rocioparra/E2_TP1/Informe/e2_tp1_main.tex

\documentclass{article}

% preambulo:
\input{e2_tp1_preamble.tex}

\begin{document}

\newgeometry{} % margenes default para la caratula
% caratula:
\input{e2_tp1_caratula.tex}

% indice:
\tableofcontents
\newpage

% cambio los margenes para el resto del documento
\newgeometry{total={6in, 8in}}
\subfile{e2_tp1_intro.tex}
\subfile{e2_tp1_protec.tex}

\begin{figure}[htp]
	\centering
	\fbox{
	\includegraphics
	[width=\textwidth]
	{imagenes/pcb_3d_view.JPG}
	}
	\caption{3D del medelo del PCB dise\~nado}
	\label{fig:placa}
\end{figure}

\subfile{e2_tp1_barkhausen.tex}
\subfile{e2_tp1_disipador.tex}
\subfile{e2_tp1_carac_salida.tex}
\subfile{e2_tp1_ej1.tex}
\subfile{e2_tp1_ej2.tex}

\section{Conclusiones}

La fuente regulada de tensi\'on dise\~nada es capaz de regular correctamente entre 9V y 15V de salida, con hasta 1.5A de corriente.

La protecci\'on foldback del circuito logr\'o reducir a 1A la corriente con tensi\'on de salida 0. Siendo que incluso as\'i se podr\'ian disipar m\'as de 20W en el transistor de paso, y su temperatura aumentaba considerablemente incluso con un disipador de 3.5$\nicefrac{W}{^\circ C}$,  es razonable suponer que sin este tipo de protecci\'on no se habr\'ia podido evitar que se queme la placa en estas condiciones. Si bien eventualmente se llegar\'ia a un l\'imite por la m\'axima corriente que puede entregar la fuente de corriente al transistor de paso, como al dise\~nar se debe tener en cuenta los $\beta$ m\'inimos de los transistores, y estos tienen una gran dispersi\'on, tambi\'en es dif\'icil conseguir que la corriente m\'axima sea mayor que la que se desea como para garantizar que se pueda utilizar la carga m\'axima, pero no tanto mayor como para que se queme la placa. 

\clearpage

\end{document}
