rocioparra/E2_TP1/Informe/e2_tp1_caratula.tex

\begin{titlepage}
\newcommand{\HRule}{\rule{\linewidth}{0.5mm}}
\center
\mbox{\textsc{\LARGE \bfseries {Instituto Tecnol\'ogico de Buenos Aires}}}\\[1.5cm]
\textsc{\Large 22.12 Electr\'onica II}\\[0.5cm]

\HRule \\[0.6cm]
{ \Huge \bfseries Trabajo de laboratorio 1
\\ Fuente regulada de tensi\'on}\\[0.4cm] % Title of your document
\HRule \\[1.5cm]

{\large

\emph{Grupo 4}\\
\vspace{3px}

\begin{tabular}{lr} 	
\textsc{Bual\'o}, Santiago Andr\'es  & 57557 \\
\textsc{Laguinge}, Juan Mart\'in  & 57430 \\
\textsc{Martorell}, Ariel Antonio  & 56209 \\
\textsc{Parra}, Roc\'io  & 57669 \\
\end{tabular}

\vspace{20px}

\emph{Profesores}\\
\vspace{3px}
\textsc{Hirchoren}, Gustavo Abraham\\ 	
\textsc{Petrucci}, Javier David\\ 	

\vspace{100px}

\begin{tabular}{ll}

Presentado: & 23/04/2019\\

\end{tabular}

}

\vfill

\end{titlepage}
