rocioparra/E2_TP1/PCB/E2_TP1/Project Outputs for E2_TP1/Board Information - pcb_e2_tp1.txt

Board Information Report
Filename     : C:\Users\Jones\Documents\GitHub\E2_TP1\PCB\E2_TP1\pcb_e2_tp1.PcbDoc
Date         : 4/18/2019
Time         : 5:58:12 PM
Time Elapsed : 00:00:00

Routing Information
    Routing completion, 100.00%
    Connections, 43
    Connections routed, 43
    Connections remaining, 0
count : 4
