rocioparra/E2_TP1/Informe/e2_tp1_main.pdf

# Instituto Tecnológico de Buenos Aires

22.12 Electronica II ´

# Trabajo de laboratorio 1 Fuente regulada de tensión

Grupo 4
Bualó, Santiago Andrés | 57557
Laguinge, Juan Martín | 57430
Martorell, Ariel Antonio 56209
Parra, Rocío | 57669

Profesores
Hirchoren, Gustavo Abraham Petrucci, Javier David

Presentado: 23/04/2019

## Índice

1. Introducción | 2
2. Diseño de la fuente regulada de tensión | 3
3. Análisis de la protección | 6
4. Compensación de ganancia | 8
5. Cálculo del disipador | 9
6. Característica de salida | 10
7. Power supply rejection ratio (PSRR) | 12
8. Rendimiento | 13
9. Impedancia de salida | 14
10.Conclusiones | 17

1

## 1. Introducción

En el presente informe, se diseñará una fuente regulada de tensión, realizando un análisis teórico de su funcionamiento, simulando el mismo en LtSpice y finalmente verificando que esto se cumpla con mediciones en el circuito real.
Los requerimientos para el diseño son:
VO [V] | IO MAX [A]
9 < VO < 15 | 1.5

Tabla 1: Requerimientos de la fuente regulada de tensión a diseñar.

Como la tensión de salida no necesita llegar a 0V en regulación, se decidió utilizar la configuración no inversora vista en clase (donde la tensión de salida siempre es mayor a la de referencia).

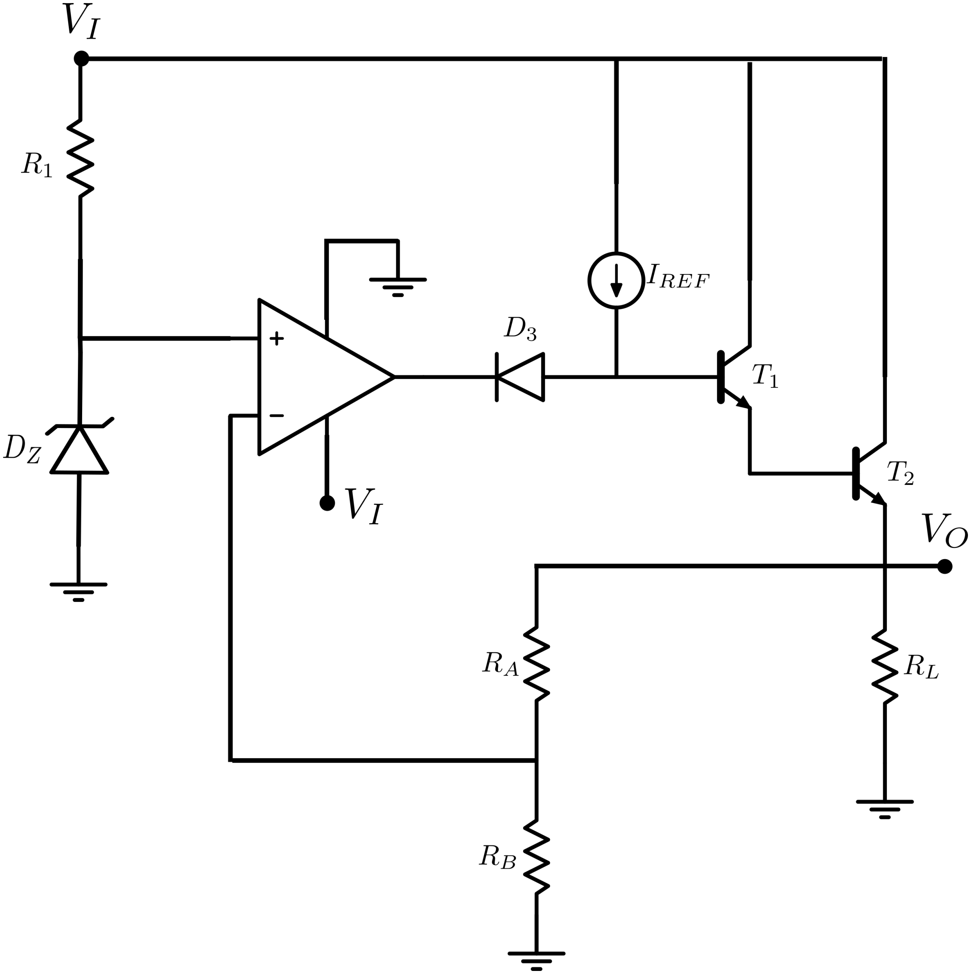
[picture p3: figure]

Figura 1: Diseño básico de la fuente regulada de tensión

2

## 2. Diseño de la fuente regulada de tensión

El circuito básico del que se partió (como se observa en la figura 1) obtiene la tensión de referencia a partir de un diodo Zener, que es comparada mediante un opamp con un divisor resistivo de la tensión de salida. Despreciando la corriente que entra al operacional, la salida se obtiene como:

VO =

1 +

RA
RB
- VZ | (1)

De esta manera, cambiando el valor de RA se puede variar la tensión de salida.
La realimentación se completa con el par Darlington y la fuente de corriente. El par funciona como transistor de paso, aportando la diferencia de tensión necesaria para que VO sea la de regulación. La realimentación del circuito hace que el opamp consuma la corriente suficiente como para que a la base de T1 llegue la justa y necesaria para que la salida se mantenga en regulación. El diodo D1 impide que el opamp entregue corriente, con lo cual la corriente máxima de salida se tiene cuando la totalidad de la entregada por la fuente va al transistor.

### 2.1. Generador y detector

Para obtener el rango establecido en la tabla 1, se decidió utilizar un diodo Zener con tensión nominal de 8.2V, de forma tal que con RB = 47kΩ y utilizando un preset de 50kΩ como RA, se puede llegar a los valores de VO requeridos. Si bien el valor exacto de los componentes no es particularmente relevante en el circuito, se eligieron en este orden de magnitud con el objetivo de que circule por ellos una corriente relativamente pequeña (de alrededor de VZ/RB ' 0.17mA), sin introducir el ruido que una resistencia del orden de los megaohms provocaría.
En cuanto a R1, la presencia de la misma tiene el único propósito de llevar al Zener a regulación. De acuerdo a la hoja de datos de este componente¹
, para que esto ocurra, la corriente debe ser mayor a IZK = 0.5mA, con valor nominal de IZT = 20mA, con su límite superior dado por la potencia de 0.5W que se puede disipar (si bien se trabajó órdenes de magnitud por debajo de este límite, para que el diodo no caliente). En nuestro circuito, esta corriente está dada por:

IZ =

VI − VZ
R1

Por lo tanto, sus mínimos y máximos coincidirán con los de la tensión de entrada. Se consideró que la tensión mínima de entrada es VI M IN = VO M IN + 1.5V = 10.5V, y la máxima, VI MAX = VO MAX + 5V = 20V (sobredimensionando en ambos casos). Se eligió entonces R1 = 560Ω, con lo cual se obtiene IZ M IN = 4.1mA e IZ MAX = 21.1mA.

### 2.2. Circuito de control: par Darlington

Se decidió utilizar dos transistores para el Darlington, en lugar de un integrado, para tener más control sobre el diseño del mismo. Por ejemplo, la mayoría de los pares Darlington del pañol de la universidad poseen resistencias entre la base y el emisor de T2, y lo mismo para T1. Sin embargo, con los transistores elegidos (como se verá a continuación), estas resistencias no ayudan a llevar los β a un punto mejor, y por lo tanto se decidió obviarlas.
A la hora de elegir T1 y T2, la principal consideración que se tuvo es que pudieran soportar holgadamente la corriente máxima. En segundo lugar, se tuvo en cuenta los rangos de β aportados

1https://www.onsemi.com/pub/Collateral/1N5221B-D.PDF, consultada 18/04/19.

3

por el fabricante, buscando el mayor mínimo y la menor dispersión posible. Por último, se consideró también el precio de cada componente listado en el pañol de la universidad.

### 2.2.1. Elección de T2

Para T2, sabemos que debe soportar toda la corriente de salida. Como debemos asegurar que se llegue por lo menos a 1.5A, y este valor dependerá considerablemente de los β, se descargaron modelos que sólo garantizacen correcto funcionamiento hasta 2A o menos. Dejando de lado también los que están diseñados para más de 15A (los cuales suben mucho de precio y pierden demasiado β, y sabemos que no trabajaremos con corrientes tan elevadas), quedaron los modelos listados en la tabla 2.

Modelo | IC MAX (A) | βM IN (veces) | βMAX (veces) | Precio (USD)
TIP31C | 3 | 10 | 50 | 0.26
TIP41A | 6 | 15 | 75 | 0.28
TIP3055 | 15 | 20 | 70 | 0.43

Tabla 2: Características de los modelos considerados para T2

Se observa en dicha tabla el TIP41A posee un β un 50 % mayor y el doble de corriente, por sólo dos centavos de dólar más. Si bien en este circuito 3A son suficientes, puesto que el TIP41A está diseñado para trabajar con corrientes muy superiores a las que necesitamos, mantiene para IO = 2A su valor de β casi sin caída, lo cual no ocurre con el TIP31C. En cuanto al TIP3055, la corriente que soporta es innecesariamente alta, y el β es de similares características al del TIP41A. Como su precio es considerablemente superior al de los otros transistores sin mejoras considerables respecto del TIP41A, se descartó. Se utilizó pues el 41A. Por lo discutido en cuanto a las características de su β en las corrientes que utilizaremos, se decidió no agregar resistencias al par Darlington.

### 2.2.2. Elección de T1

Si sobredimensionamos la corriente máxima de salida un 10 % (puesto que debemos asegurar que se llegue a 1.5A, y por lo tanto diseñar para llegar a más), el otro transistor debe soportar una corriente máxima de:

IT1 MAX =

IT2 MAX

βT2 M IN

≤

1.65A
15

= 110mA

Nótese que incluso considerando 2A se obtienen valores inferiores a 200mA, y sólo con 1.5A se obtiene 100mA, con lo cual podemos decir con confianza que IT1 MAX debe ser superior a 100mA. Descartando los que soportan más de 1A, quedan sólo el 2N3904 y el BC337. Si bien este último cuesta un poco más del doble (0.10U$D contra 0.04U$D), se eligió este modelo de todas maneras por los siguientes motivos:

Ambos tienen el mismo β mínimo, pero el máximo del BC337 es el doble de grande.

Con IC = 100mA, el β del 2N3904 se reduce un 70 %, mientras que la curva del BC337 se encuentra en su máximo en este punto.

El BC está diseñado específicamente para amplificación, y el 2N es de uso general.

4

### 2.3. Amplificador de error

En esta fuente regulada, el amplificador de error consiste en un opamp, que compara (resta) la tensión de referencia, generada por el Zener, con una fracción de la de salida. A la salida del operacional se tendrá la tensión necesaria para minimizar el error.
Este operacional debe contar con la posibilidad de ser alimentado con 0−VCC , en lugar de ±VCC , puesto que se lo alimentará con la tensión de entrada. Debido a limitaciones en la disponibilidad de componentes en el pañol, la única opción disponible que cumplía con nuestros requisitos fue el LM358. Sin embargo, esto no implica que no sea adecuado para la aplicación que le daremos: con 100dB de PSRR, y 100dB también de ganancia, se adapta perfectamente al uso que le daremos, en el cual la alimentación no será necesariamente estable (pues es la entrada) y se requiere la mayor ganancia posible. A su vez, el fabricante asegura que este integrado puede sinkear más de 10mA, con lo cual será capaz de aceptar toda la corriente de referencia sin quemarse.

### 2.4. Pre-regulador: fuente de corriente

La fuente de corriente que se utilizó se observa en la figura 2. El funcionamiento de la misma es el siguiente: la resistencia R5 permite que se polaricen los diodos en directa, generando en la base de T3 una tensión de VB3 = VI − 2VD ' Vin − 1.4V. Luego, cuando el transistor esté correctamente polarizado (lo cual dependerá de la diferencia entre VI y VO), en la resistencia R6 caerá una tensión de VR6 = VI −VE3 = VI −(VB3 +VBE3

) = VI −(VI −2VD +VBE3

) = VD si consideramos VBE3 = VD.

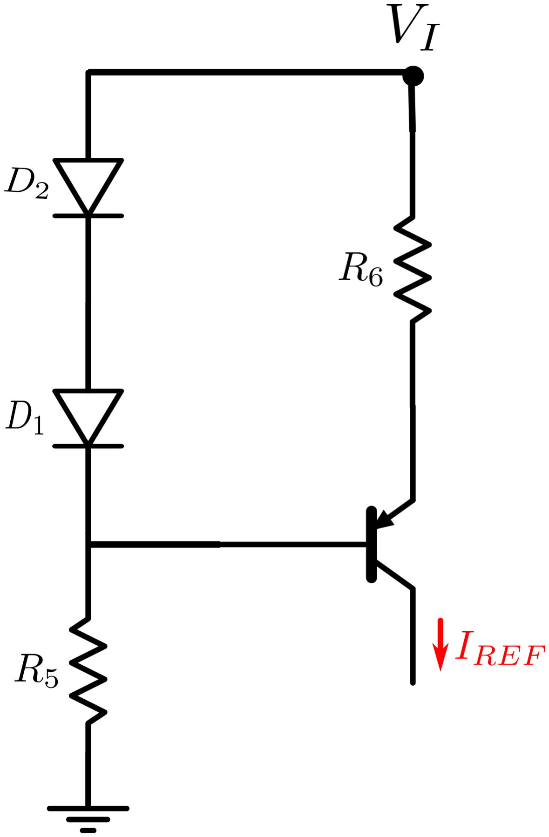
[picture p4: figure]

Figura 2: Fuente de corriente utilizada en el regulador de tensión

Por lo tanto, como la corriente de salida es aproximadamente igual a la de R6 (despreciando IB3

),
se obtiene:

IREF =

0.7V
R6

(2)

Si sobredimensionamos la corriente máxima un 10 % (considerando las aproximaciones que se

5

hicieron, posibles diferencias en las VD y VBE con los 0.7V teóricos, etc), se obtiene:

IREF =

1.1 · IO MAX

βM IN 1 · βM IN 2

=

1.1 · 1.5A
100 · 15

= 1.1mA

Por lo tanto, se eligieron los componentes:

R5 = 10kΩ, con lo cual los diodos se polarizan con una corriente de entre 0.96mA y 1.86mA (dado que la hoja del 1N4148 recomienda 1mA si se quiere 0.7V).

R6 = 642Ω (560 Ω en serie con 82Ω), con lo cual se tiene IO MAX ' 1.6355A, que es lo más cercano que se pudo llegar, con valores comerciales, a los 1.65A que se propuso.

T3 = BC557, un transistor PNP de uso general, que era el más barato (la mitad que el siguiente más barato) y con mayor disponibilidad del pañol de la universidad, y con IC = 100mA y VCE = 45V es más que suficiente para este uso.

## 3. Análisis de la protección

Se decidió utilizar una protección foldback dado que esta evita el pasarnos de la corriente de salida máxima establecida, Iomax´ = 1.5 A y nos limita la cantidad de potencia a disipar por una menor a la dada por una protección lineal reduciendo costos. Al agregar la protección foldback nos quedamos con el siguiente circuito:

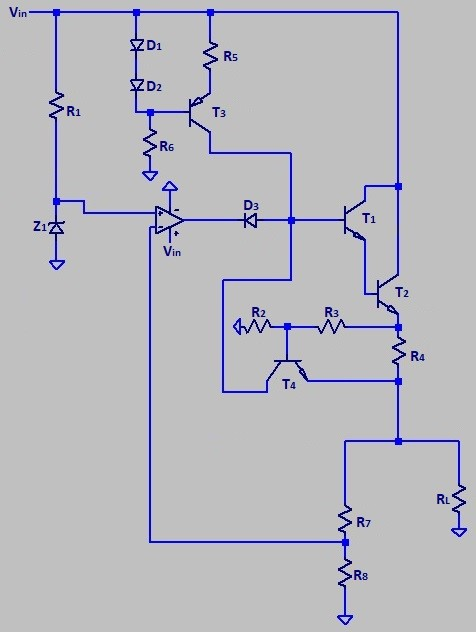
[picture p5: figure]

Figura 3: Circuito con protección

De la figura 3 podemos observar que la protección va a tener los siguientes parámetros:

6

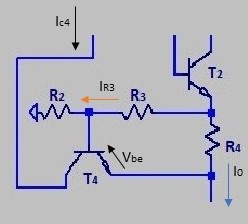
[picture p6: figure]

Figura 4: Análisis del circuito

De la figura 4 al recorrer la malla marcada obtenemos la siguiente ecuación:

(Io − Ie4)R4 = Vbe +

V0 + (Io − Ie4)R4
R2 + R3

R3

Dado que la corriente Ie4 es la corriente que viene de la fuente de corriente y debido a que la corriente Io es dado por β1β2 podemos despreciar la corriente Ie4 dando como resultado la siguiente ecuación:

IoR4 = Vbe +

V0 + IoR4
R2 + R3

R3

Para la elección de los componentes se fijaron los componentes R3 y R4 de forma tal que el componente R2 se elige a partir del siguiente despeje:

R2 =

(Vo + IOR4)R3

I0R4 − Vbe

R3 − R3

Se despejo el valor de R2 utilizando las siguientes condiciones:

Elemento | Valor
R4 | 0.6 Ω
R3 | 1 kΩ
Vo | 9 V
I0 | 1, 58 A

Dando como resultado que R2 = 396112 Ω donde asumiendo la posibilidad de un error del 8 % se eligió a I0 como el valor dado por 3 así como el valor de Vo fue elegido para mantener la máxima corriente requerida incluso para el valor más chico de Vo. Finalmente, con la simulación generada en LTSpice se vario ligeramente el valor para tener el resultado querido, dando como valor final a R2 = 39 kΩ. Al realizar la comprobación empírica para obtener lo querido se tuvo que cambiar R3 = 1, 5 kΩ dando como resultado final los siguientes valores para los componentes:

Elemento | Valor
R4 | 0.6 Ω
R3 | 1, 5 kΩ
R2 | 39 kΩ

7

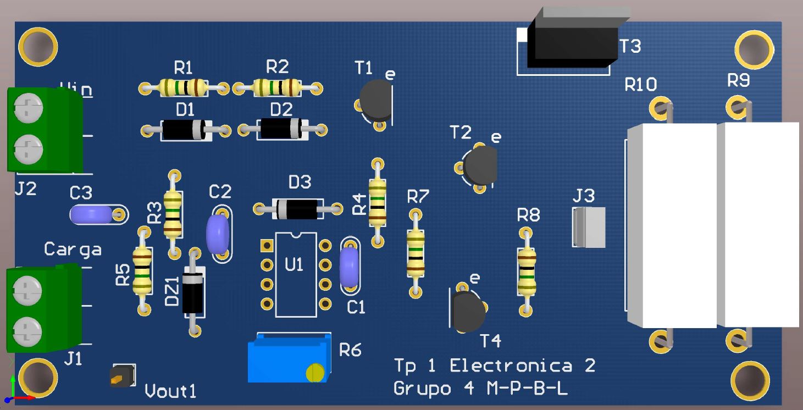
[picture p7: figure]

Figura 5: 3D del medelo del PCB diseñado

## 4. Compensación de ganancia

Si bien el comportamiento del circuito que más nos interesa es en continua, las múltiples capacida-des de juntura y el lazo de realimentación provocan que la respuesta en frecuencia de este circuito no sea constante. Por lo tanto, surge la necesidad de garantizar que para ninguna frecuencia se cumpla el criterio de Barkhausen, es decir:
(
|T(f)| = 1
T(f) = 180◦

Una forma de garantizar que esto no ocurra es forzar la existencia de un polo en bajas frecuencias, de forma tal que se llegue a 0dB para frecuencias bajas y controlando que ese salto no sea en simultáneo con una fase cercana a 180◦ para que el sistema no oscile
Se procuró lograr esto insertando un capacitor entre la salida del amplificador de error y la realimentación, de forma tal que en altas frecuencias (cuando el capacitor es un cable) la señal se vea atenuada. Al simular con un capacitor de 10nF, se obtuvieron los márgenes observados en la tabla 3.
Margen de amplitud (dB) | 12.9
Margen de fase (◦ ) | 90

Tabla 3: Márgenes de ganancia y amplitud con C=10nF

8

## 5. Cálculo del disipador

### 5.1. Introducción

Cuando uno o varios componentes electrónicos de un circuito por cuestiones de diseño deben disipar mucha potencia (traducida en calor al exterior), generalmente dichos dispositivos no son capaces de hacerlo sin llegar a la propia falla y/o romperse. Es por esto que para estos casos se utilizan los llamados disipadores térmicos. Estos disipadores son piezas generalmente metálicas que utilizando las leyes de la termodinámicas son capaces de extraerle calor al componente y liberarlo al ambiente. Existen disipadores de varias formas, tamaños y materiales.

### 5.1.1. Fundamento matemático

Gracias a la física, es posible establecer una analogía entre la ley de Ohm para corrientes y la propagación térmica del calor en los distintos materiales, de manera tal como podemos observar en la tabla siguiente:

Ley de Ohm | Propagación térmica
Intensidad de corriente (I) | Calor (W)
Tensión (V) | Temperatura (T)
Resistencia (R) | Resistencia Termica (R)
V = I · R | T = W · R

Tabla 4: Analogía térmica-ley de Ohm.

Siendo el calor expresado en Watts, la temperatura expresada en oC, y la resistencia térmica expresada en oC/W.
La resistencia térmica, al igual que la resistencia para la ley de Ohm, es inherente a cada material en sí, de manera tal de que por ejemplo un aislante térmico posee alta resistencia térmica, y un conductor térmico perfecto posee baja resistencia térmica.

### 5.2. Elección del disipador

### 5.2.1. Cálculo de Potencia máxima disipada

Correspondiente al análisis que se hizo del circuito en puntos anteriores, el transistor de nuestro circuito que mayor potencia va a disipar es el transistor T2, correspondiente al par dárlington, el cual por diseño va a tener que soportar una corriente cercana de aproximadamente 1.5 A. Para hallar la potencia máxima que este transistor disipa, primero debemos saber en qué condiciones va a hacerlo. Para ello, sabiendo que:
(
PDT 2 = [Vi − V0(i0)] · io | siendo la potencia que disipa el transistor T 2 (1)
i0R4 = (V0 + i0R4) ·

R3
R3+R4
+ 0.7 ecuacion de F oldBack ´ | (2)

Debemos de despejar V0 de la ecuación de foldback, insertarla en la ecuación de la potencia del transistor T2 y derivarla respecto a i0 para hallar su máximo.
Haciendo las cuentas pertinentes, notamos que la mayor disipación de potencia en el transistor T2 ocurre cuando se pone la fuente en corto, es decir cuando i0 = 1.5 A. Sobredimencionando Vi = 22 V , reemplazando los valores en la ecuación (1) obtenemos una potencia PT2 = 22.88 W.

9

### 5.2.2. Elección del disipador

Una vez conocida la potencia máxima disipada, podemos aplicar la ley de propagación térmica vista previamente para así calcular cuál es la resistencia térmica que debe tener el transistor. La ecuación pertinente se puede observar a continuación:

Tmax´ = Ta + Pmax(

PRθi)

Donde Tmax es la temperatura máxima a la cual el componente puede operar, TA es la temperatura ambiente a la cual está expuesto el dispositivo, Pmax es la potencia máxima, y Rθ es la resistencia térmica (de lo/s componentes que correspondan).
Sabemos por la hoja de datos que el transistor TIP 41 posee una resistencia térmica juntura-ambiente es de un valor Rθja = 50

oC
W . Sabiendo además que la Tmax de operación del transistor es de 150oC , y suponiendo una TA = 24oC, la temperatura del dispositivo se expresa según la ecuación de arriba como T = 24 + 24 ∗ 50 = 1224o donde claramente es evidente el uso de un disipador para poder funcionar.
Procedemos entonces a calcular cuánto debe valer la resistencia térmica de todo el conjunto para que el transistor no se queme. Para ello, despejamos Rθ de la ecuación de arriba, de manera tal de que, reemplazando, obtenemos:

PRθ =

Tmax−TA
Pmax

= 5.25 oC
W
Ahora, con el acoplado del disipador, la Rθ total, está compuesta por la resistencia juntura-carcasa del transistor; y las resistencias carcasa-sink, sink-ambiente del disipador. Por la hoja de datos del transistor, sabemos que la resistencia juntura-carcasa es de un valor Rθjc = 1.67

oC
W como máximo,
ergo debemos buscar un disipador cuyas Rθcs + Rθsa ≤ 3.847

oC
W .
Existen disipadores de varios tamaños, formas y materiales distintos, por lo que para elegir el correcto, comparamos las resistencias de dichos disipadores para así poder elegir el óptimo. En particular, el nuestro debe ser para encapsulados TO220, y con un Rθ relativamente bajo.
Vemos como el modelo del disipador ZD-1, con unas medidas medidas de base 58 mm, altura 29mm, espesor del núcleo central 3.5mm, distancia entre aletas de 33mm, genera una superficie total de 525.10 mm²/mm lo que produce un Rθca = 3.5

oC/W, la cual se acopla perfecto con nuestro diseño. Habiendo elegido este modelo, ahora la temperatura final del componente va a ser de Tmax´ = 24 + 22.88 · (3.5 + 1.67) = 130.85oC con lo cual el dispositivo puede operar en todos los rangos posibles para los que fueron diseñados.

## 6. Característica de salida

Se realizaron mediciones de la tensión y la corriente de salida para distintos valores de carga, obteniéndose así las curvas características del circuito. Las mismas se realizaron para tres tensiones de regulación distintas: 9V (figura 6), 12V (figura 7) y 15V (figura 8).
En las mediciones, se observa que la tensión de corto circuito real fue menor a la simulada, que a su vez fue menor a la calculada. Recordando la expresión de esta corriente:

IO CC =

VBE 4
R4
·
1 +

R2
R3

De aquí resulta evidente que esta corriente depende considerablemente de la polarización de T4. Si bien en los cálculos se consideró VBE = 0.7V, en la simulación se observa que esta tensión es

10

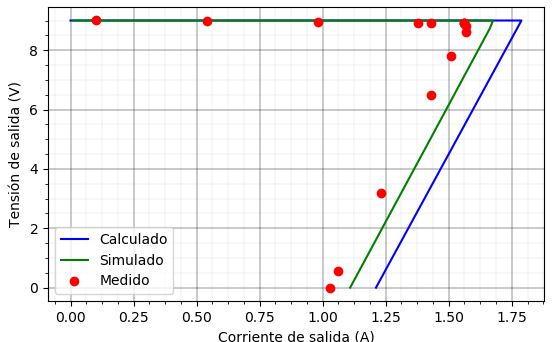
[picture p8: figure]

Figura 6: Curva de salida calculada, simulada y medida, con VO|REG = 9V

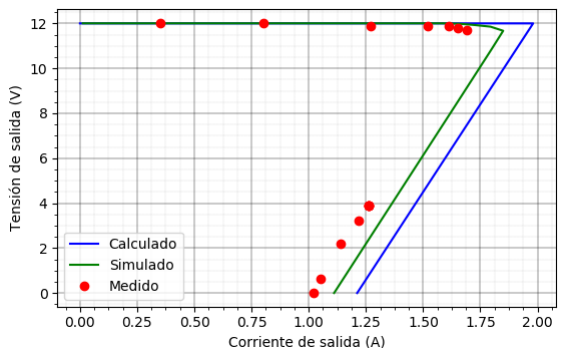
[picture p9: figure]

Figura 7: Curva de salida calculada, simulada y medida, con VO|REG = 12V

11

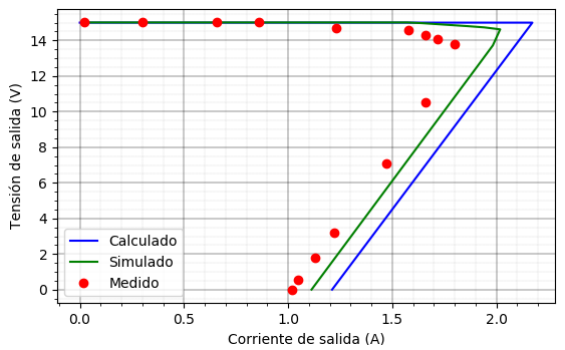
[picture p10: figure]

Figura 8: Curva de salida calculada, simulada y medida, con VO|REG = 15V

de 0.65V, lo cual reduce el valor de IO CC un 7.14 %: de 1.2A a 1.11A, lo cual explica la diferencia entre el cálculo y la simulación. En cuanto a la diferencia entre la simulación y la medición, puede atribuirse el error obtenido a la tolerancia de los componentes (sobre todo de R2, cuya sensibilidad es particularmente alta, dado que R2 es considerablemente menor a R3).
Otra diferencia notable entre la curva calculada y las demas está en la caída de tensión que se observa en la salida incluso antes de entrar en foldback. Los cambios pequeños que se observan para corrientes menores a 1.5A se pueden atribuir a que la impedancia de salida no es exactamente 0, y por lo tanto la regulación de línea no es del todo perfecta. Pero para corrientes superiores, se comienza a observar un descenso mayor en la tensión. Esto se debe mayormente a que tanto en la simulación como en las mediciones se utilizó VI ' VO REG + 3V, pero para las corrientes más grandes se observa que esta tensión no polariza el circuito de la forma más óptima. En la simulación se verificó que al aumentar la tensión de entrada a VI = VO + 5V , se obtiene una característica mucho más recta en regulación.

## 7. Power supply rejection ratio (PSRR)

El factor de rechazo de a fuente de alimentacíon se utiliza para describir que tan inmune es un circuito electrónico a variaciones en la tensión de entrada y se define de la siguiente manera:

P SRR(dB) = 20 log10 (

∆Vfuente

∆Voutput

) | (3)

Acontinuación se analizará dicho factor en la fuente regulada realizada utilizando una fuente de tensión continua de 12V provista con un nivel prominente de ripple(1Vpp) y a su vez variando la carga. En las siguientes tablas se puede observar los resultados de las simulaciones y las mediciones. Como se puede observar los valores del PSRR de las mediciones presentan diferencias considerables que se deben a multiples factores. Uno de estos se debe a que al estar presente esta variación en la

12

Rload | Vin | Ripplein(Vpp) | Rippleout(Vpp) | P SRR(dB)
∞ | 12 | 1 | 0.0024 | 52,177
21Ω | 12 | 1 | 0.3527 | 9,051891

Tabla 5: valores de PSRR simulados

Rload | Vin | Ripplein(Vpp) | Rippleout(Vpp) | P SRR(dB)
∞ | 12 | 0.144 | 0.0009 | 44.082
21Ω | 12 | 1,7 | 0.4 | 12.56

Tabla 6: valores de PSRR medidos

tensión de entrada los valores de tensión en los cuales trabajan los diodos y transistores, por lo cual cambian sus puntos de trabajo y polarización de estos ultimos.

## 8. Rendimiento

Un parámetro fundamental de una fuente de tensión regulada es el rango de tensiones de entrada en el cual la salida se encuentra en regulación. Idealmente, con cualquier tensión igual o supuerior a la de salida se podría obtener VO REG, pero la necesidad de llevar a los transistores del circuito a un punto de trabajo apropiado hace que haya una diferencia de tensión mínima entre la entrada y la salida.
Partiendo desde la salida, la tensión en el nodo común a las resistencias R4 y R7 es igual a Vo. Despreciando la tensión que cae en la resistencia R4, puesto que es muy pequeña, asumimos que en el colector del transistor T2 obtenemos la tensión Vo. Sabemos por la hoja de datos del fabricante, que para que el transistor T2 no entre en saturación es de 1V como máximo para las condiciones de nuestro circuito, por lo que vamos a asumir que el valor de Vce = 1V ; ahora, al igual que para T2, la hoja de datos del transistor T1 nos indica que Vcesat = 600mV como valor máximo. Ahora, planteando mallas entre los transistores del par darlington, vemos que:

VceT 1 = VceT 2 − VBEon

Como VceT 1 = 0.6V ,VBEon = 0.7V despejando obtenemos que VceT 2 = 1.4V , valor admisible dentro del rango del transistor T2. Finalmente, Vin puede expresarse como:
Vin = VceT 2 + Vo

siendo VceT 2 = 1.4V .
Cabe destacar que los fabricantes proporcionan una Vcesat mínima, por ende, el valor final puede ser mas bajo. Si se tienen en cuenta los valores mínimos, VceT 1 = 0.2V y VceT 2 = 0.1V , lo que hace que Vin = 0.8V + Vo.
Por otro lado, hay que verificar también que la fuente de corriente se polarice correctamente. Recorriendo la rama que une la entrada, los diodos de la fuente y T3, y yendo desde la salida hasta el colector de T3 (despreciando nuevamente la caída en R4), se obtiene:
(
VE3 = VO + VBE1 + VBE2
VC3 = VI − 2VD + VBE3

⇒ VEC3 = VI − VO + 2VD + VBE1 + VBE2 − VBE3

(4)

Por lo tanto, si no queremos que T3 sature, debe cumplirse que:

VI − VO > VEC3SAT + 2VD + VBE1 + VBE2 − VBE3

(5)

| | | 13

Si asumimos que todas las VBE y VD son 0.7V, tomando los 0.3V de la hoja de datos del BC557 como VCE3SAT , se obtiene que VI − VO > 2.4V. Esta condición es, entonces, más restrictiva que la polarización correcta del par Darlington, y por lo tanto dictará si el circuito regula o no.
Tomando como criterio que el circuito está regulando correctamente si la tensión de salida es un 99 % o más de la que se tiene sin carga, se obtuvieron los datos de la tabla 7.
VO REG (V) | VI − VO simulada (V) | VI − VO medida (V)
9 | 1.263 | 1.37
10 | 1.273 | 1.37
11 | 1.281 | 1.5
12 | 1.286 | 1.18
13 | 1.290 | 1.29
14 | 1.293 | 1.26
15 | 1.295 | 1.13

Tabla 7: Rendimiento medido y simulado para distintas tensiones de regulación

En promedio, pues, se obtuvo que:
(
∆VM IN SIM = 1.28V
∆VM IN MED = 1.3V

(6)

Esto es más de un volt menos de lo que se había obtenido analíticamente (1.4V). Esto se debe a que empíricamente se verifica que todas las tensiones de juntura PN en directa que se asumieron como 0.7V son en realidad inferiores, y por lo tanto el circuito funciona correctamente para valores menores de VI .

## 9. Impedancia de salida

Una característica de una fuente de tensión regulada ideal es que posee impedancia de salida cero, lo cual resultaría en regulación de carga ideal, es decir: la tensión de salida es la misma para cualquier valor de RL. Desde ya, en la práctica esto es imposible de obtener, pero la realimentación negativa de este tipo de fuentes permite obtener un valor de RO lo suficientemente pequeño como para que sea despreciable en la mayoría de los casos.
Analíticamente, el valor de RO se obtiene a partir de la impedancia de salida del circuito amplificador básico ROA y la ganancia de lazo |T|:

RO =

ROA
1 + |T|

(7)

En la ecuación 7 resulta muy claro por qué la realimentación negativa mejora esta característica del circuito: en lugar de ver directamente la impedancia de salida del circuito amplificador básico, la carga ve a esta impedancia reducida 1 + |T| veces.
El análisis se realizo eligiendo el generados, el amplificador, la re-alimentación de la siguiente manera:

14


Figura 9: Elección de etapas

A partir de la figura 9 podemos observar que la vamos a tener suma de tensión y muestreo de tensión dando una ganancia de re-alimentación f =

V1
V2

|I1=0 =

R8
R8+R7

. A continuación calculamos la ganancia a lazo abierto con el siguiente circuito:


Figura 10: Elección de etapas

En donde reemplazamos el transistor T3 junto sus correspondientes componentes por una fuente de corriente para simplificar el análisis y remplazamos el generador por un Vg de forma tal que nos queda lo observado por la figura 10. De la misma podemos observar que la ganancia a lazo abierto

15 nos va a dar como resultado:

a =

V2
V1

=

(Avol − VD3 − V BE1 − V BE2 + I3Rout)(Z2//RL)(β1 + 1)(β2 + 1) Vg[Rout + (β1 + 1)(β2 + 1)(Z2//RL)]

Al cual aproximando (Avol−VD3−V BE1−V BE2+I3Rout)(Z2//RL)(β1+1)(β2+1) ' Avol, dado que todas las demás variables son chicas en comparación a Avol la cual se encuentra multiplicada por la ganancia del amplificador del operacional y que tiene mayor valor que el resto. Ademas aproximamos Vg[Rout + (β1 + 1)(β2 + 1)(Z2//RL)] ' (β1 + 1)(β2 + 1)(Z2//RL) dado que Rout va a ser despreciable en comparación a (β1 + 1)(β2 + 1)(Z2//RL) quedando:

a =

Avol(Z2//RL)(β1 + 1)(β2 + 1) Vg(β1 + 1)(β2 + 1)(Z2//RL)

=

Avol
Vg

Dado que = Vg

Rent
Rent+Z1

tenemos que el valor final va a ser a =

AvolRent
Rent+Z1

. Finalmente, dado que
Z1 = R8//R7 y Z2 = R8 + R7 obtenemos que a ' Avol porque Rent Rent+Z1
' 1.
Para obtener la impedancia de salida calculamos la impedancia de salida dada por los transistores T1 y T2 los cuales están en una configuración DARLINGTON, utilizando el modelo incremental

obtenemos Rout =

rπ1
1+β1

+rπ2
1+β2

y dado que rπ = (1 + β)

VT
Icq

estas van a variar acorde a la corriente de polarización y la temperatura a la cual se este usando el transistor. Finalmente obtuvimos analíticamente que:

|T| ' Avol

R8
R7 + R8

' 99, 18 dB

ROA ' RL//Z2//ZoutCascode

(8)

Remitiéndonos nuevamente a la ecuación 7, resulta entonces en el caso típico donde Icq2 = 1, 5 A y estando a temperatura ambiente, que:

RO ' 379 × 10⁻⁶Ω

En el peor caso donde ROA ' Z2 tenemos que:

RO ' 557 × 10⁻³Ω

Para simular y medir este valor, se estudió la regulación de carga del circuito. Si la impedancia de salida fuese cero, debería cumplirse que tanto para corriente 0 como para cualquier valor de IO, la tensión de salida es la misma. A medida que RO aumenta, más cae la tensión a medida que aumenta la corriente. Se decidió pues calcular RO a partir de:

RO =

VO|IO=0 − VO|IO=IO 1
IO 1

(9)

Si bien, en principio, esta ecuación es válida para cualquier par de valores de ∆VO y ∆IO, se decidió utilizar IO 1=1A, debido a que los valores de ∆VO en regulación son muy pequeños, y por lo tanto difíciles de medir con precisión con el instrumental que se tenía disponible, lo cual incurre en un gran error porcentual en la determinación del mismo, que se propaga proporcionalmente a RO. A pesar de que esta forma se ignora el hecho de que la impedancia de salida cambia con la carga, dado que cambia la polarización de todos los diodos y transistores del circuito, se consideró que se incurriría así en menos error que tratando de medir las variaciones de unos pocos mV (o inferiores) que ocurren en valores similares de corriente.

16

VO REG (V) | RO simulada (Ω) | RO medida (Ω)
9 | 3 × 10⁻⁶ | 6 × 10⁻²
15 | 2 × 10⁻⁶ | 2 × 10⁻²

Tabla 8: Valores simulados y medidos para la impedancia de salida

En las mediciones se obtuvieron valores casi cuatro órdenes de magnitud mayores a los calculados y simulados. Sin embargo, no habría sido posible medir valores inferiores, puesto que implicaría medir tensiones de décimas de milivolt, lo cual no es posible con el instrumental que se tiene disponible. Por lo tanto, interpretamos la impedancia de salida medida como una cota superior y no como un valor representativo.

## 10. Conclusiones

La fuente regulada de tensión diseñada es capaz de regular correctamente entre 9V y 15V de salida, con hasta 1.5A de corriente.
La protección foldback del circuito logró reducir a 1A la corriente con tensión de salida 0. Siendo que incluso así se podrían disipar más de 20W en el transistor de paso, y su temperatura aumentaba considerablemente incluso con un disipador de 3.5W/
◦C, es razonable suponer que sin este tipo de protección no se habría podido evitar que se queme la placa en estas condiciones. Si bien eventual-mente se llegaría a un límite por la máxima corriente que puede entregar la fuente de corriente al transistor de paso, como al diseñar se debe tener en cuenta los β mínimos de los transistores, y estos tienen una gran dispersión, también es difícil conseguir que la corriente máxima sea mayor que la que se desea como para garantizar que se pueda utilizar la carga máxima, pero no tanto mayor como para que se queme la placa.

17
