rocioparra/E2_TP1/caracterisitica salida/e2_tp1_carac_salida_15V.png

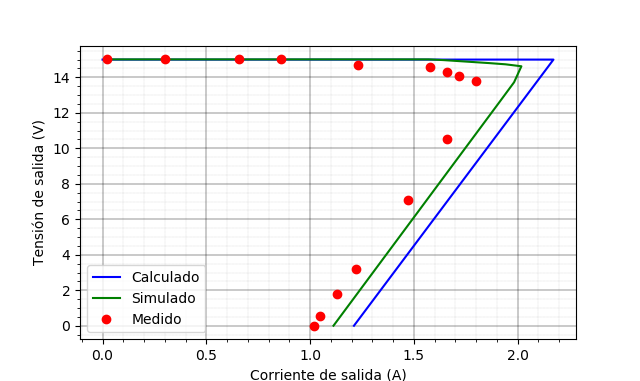
caracterisitica salida/e2_tp1_carac_salida_15V.png
