rocioparra/E2_TP1/dibujos/circ.png

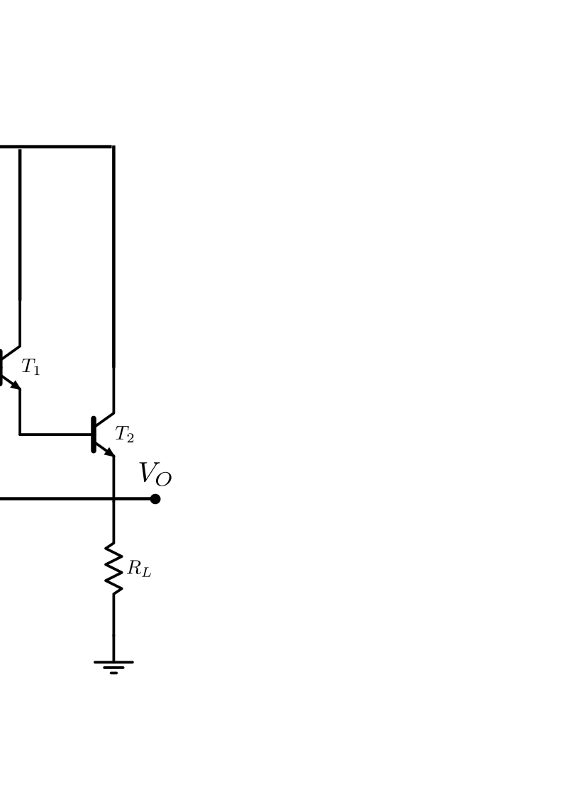
dibujos/circ.png
