rocioparra/E2_TP1/Informe/curvas_salida/e2_tp1_carac_salida_12V.png

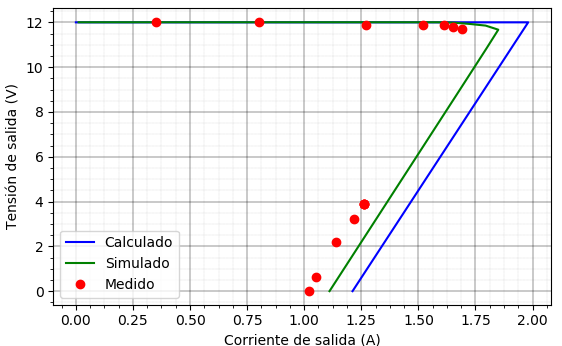
Informe/curvas_salida/e2_tp1_carac_salida_12V.png
