rocioparra/E2_TP1/Simulaciones/e2_tp1(Con_Protec).asc

D1: diode; 1N4148
D2: zener; TDZ8_2B
D3: diode; 1N4148
D4: diode; 1N4148
PRESET: res; 38976
Q1: npn; BC337-25
Q2: npn; Qtip41c
Q3: pnp; BC557B
Q4: npn; 2N2222
R1: res; 1000
R3: res; 47k
R4: res; 560
R5: res; 560
R6: res; 10k
R7: res; 1k5
R8: res; 39k
R9: res; 0.6
R10: res; 82
U1: opamp2; LM339
V1: voltage; 17.02652
Named nets: 0, in, out, realim
.lib LM339.5_1
.lib BC547.lib
;step dec param RL  1 1000 300
;dc V1 list 18 20
vo=15 -> preset=38976
vo=9 -> preset=4585
PRESET=R3*(VO/8.2 - 1)
.op
