rocioparra/E2_TP1/Simulaciones/e2_tp1(Con_Protec) simlazo.asc

C1: cap; 10n
D1: diode; 1N4148
D2: zener; TDZ9_1B
D3: diode; 1N4148
D4: diode; 1N4148
Ii: current; ""; AC {u(prb)}
pote: res; 4585
Q1: npn; BC337-25
Q2: npn; Qtip41c
Q3: pnp; BC557B
Q4: npn; BC547B
R3: res; 47k
R4: res; 560
R5: res; 560
R6: res; 10k
R7: res; 1k5
R8: res; 39k
R9: res; 1.2
R10: res; 1.2
R11: res; 82
RL: res; 1k
U1: opamp2; LMx58_LM2904
V1: voltage; 12
Vi: voltage; ""; AC {u(-prb)}
Named nets: 0, in, out, x
.lib LM339.5_1
.lib BC547.lib
.ac dec 100 0.001 100Meg
.step param prb list -1 1 ; set prb=0 to turn off probe
-1/(1-1/(2*(I(Vi)@1*V(x)@2-V(x)@1*I(Vi)@2)+V(x)@1+I(Vi)@2))
.lib LMx58_LM2904.cir
.lib LMx58_LM2904.cir
