rocioparra/E2_TP1/Simulaciones/e2_tp1.asc

D1: diode; 1N4148
D2: zener; TDZ9_1B
D3: diode; 1N4148
D4: diode; 1N4148
Q1: npn; BC337-25
Q2: npn; Qtip41c
Q3: pnp; BC557B
R1: res; 500
R2: res; 1.5k
R3: res; 2k
R4: res; 1k
R5: res; 0.569k
R6: res; 1k
U1: opamp2; LM339
V1: voltage; 20
Named nets: 0, in, out
.dc V1 20 25 1
.lib LM339.5_1
