rocioparra/E2_TP1/(list of files, drawings)

Other design files:
PCB/E2_TP1/E2_TP1.PrjPcb
PCB/E2_TP1/pcb_e2_tp1.PcbDoc
PCB/E2_TP1/pcb_e2_tp1.SchDoc
