rocioparra/E2_TP1/(commit log)

2019-04-14 Valor cambiado de 1 a 0.6
2019-04-15 Cambio de R8
2019-04-15 listo el pollo pelada la gallina
2019-04-15 resistencias corregidas
2019-04-15 para rutear
2019-04-16 pcb terminado faltan ensanchar pistas
    [pcb_e2_tp1.PcbDoc, pcb_e2_tp1.SchDoc]
2019-04-16 mismo que anterior pero me olvide una cosita
    [E2_TP1.PrjPcb]
2019-04-16 pcb final
    [pcb_e2_tp1.PcbDoc]
2019-04-17 Empezando el informe de proteccion
2019-04-18 camios al pcb
    [pcb_e2_tp1.PcbDoc, pcb_e2_tp1.SchDoc]
2019-04-18 nueva version pcb
    [E2_TP1.PrjPcb, pcb_e2_tp1.PcbDoc, pcb_e2_tp1.SchDoc]
2019-04-19 Nuevas imagenes y modificación de viejas
2019-04-20 Fin de la parte de protección
2019-04-20 valores finales (menos capacitor)
2019-04-21 pcb con los ultimos cambios
    [pcb_e2_tp1.PcbDoc, pcb_e2_tp1.SchDoc]
2019-04-22 mediciones finales!!!!!!!!!!!!!!!!!!!!!
    [mirste estas mediciones mati.xlsx]
2019-04-23 mediciones que nunca comitie ups
2019-04-23 simulaciones que pide la consigna
    [simulaciones.xlsx]
2019-04-24 Imagenes del informe de la parte de proteccion
2019-04-24 graficos caracteristica de salida
    [e2_tp1_carac_salida_med.csv, e2_tp1_foldback_12V.csv, e2_tp1_foldback_15V.csv, e2_tp1_foldback_9V.csv, simulaciones.xlsx]
2019-04-24 informe: curvas de salida
2019-04-25 humo de PSRR
2019-04-25 zout y rendimiento
    [mirste estas mediciones mati.xlsx, simulaciones.xlsx]
2019-04-25 Calculo de |T| y rout
2019-04-25 ahi va la imagen
